javicercasi/Trabajo_Final_3/58004-Cercasi/Documentacion presentada/Tesis/Trabajo Final PPT.pdf

z

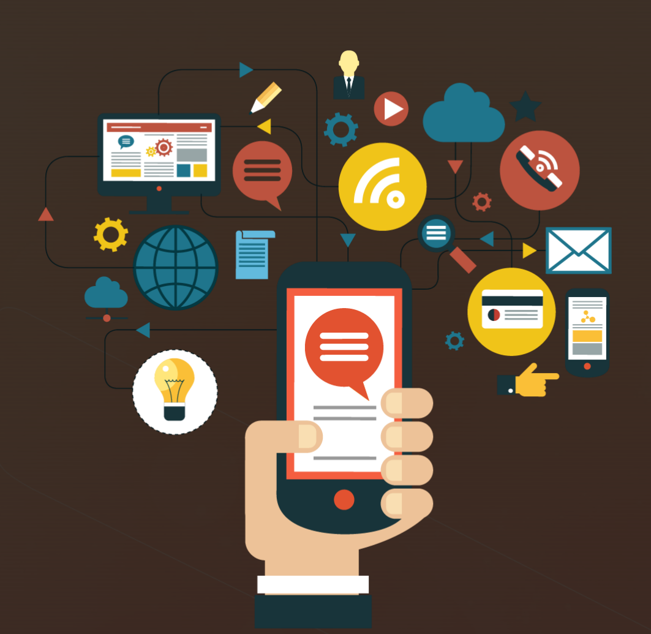
[picture p45: figure]

# Nova: Teléfono Móvil

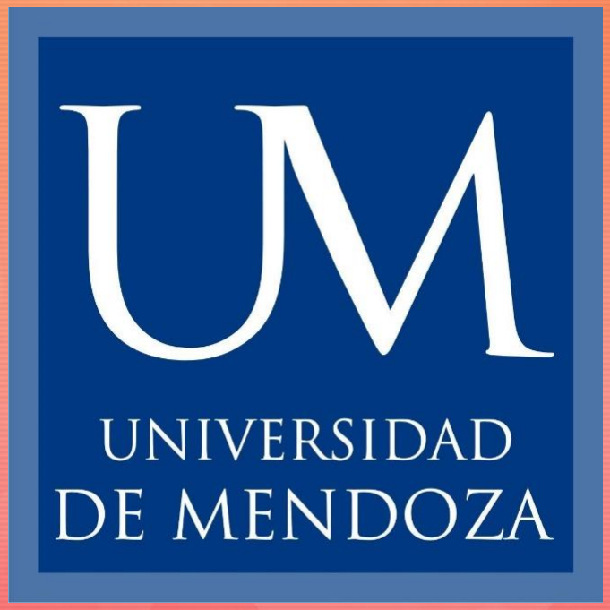
[picture p46: figure]

Trabajo Final
Ingeniería en Computación

Cercasi Javier Agustín

z

## Tabla de contenidos

01

Problema

02

Solución

03

Metodología

05

Demo

06

Conclusiones

04

Arquitectura

07

Mejoras

z

01

# Problema

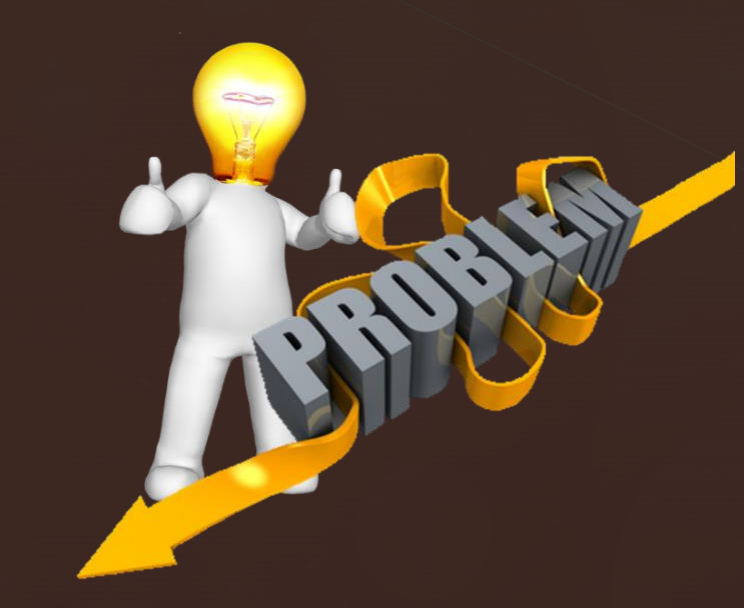
[picture p47: figure]

z

## Problema

- En la actualidad, muchos habitantes de escasos recursos y personas de la tercera edad encuentran dificultades a la hora de hallar y utilizar un dispositivo móvil que sea cómodo y sencillo de manipular. Una buena forma de disminuir esta brecha digital es facilitando su uso, y haciéndolo agradable para estos usuarios.

01

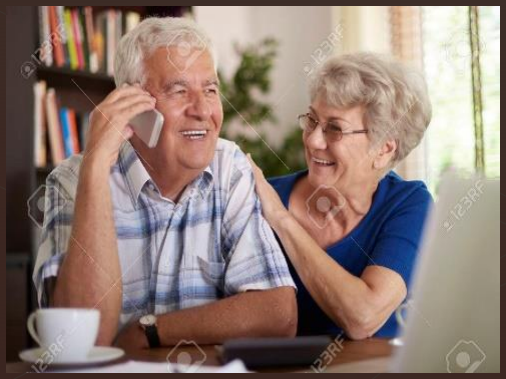
[picture p48: figure]

z

## Justificación del Problema

- Acercar la tecnología a la tercera edad es imprescindible para que puedan estar siempre conectados e integrados en la sociedad por medio de ella. Esta integración resulta además de suma importancia para las familias de estos usuarios, por la tranquilidad que brinda el saber que siempre estarán conectados.

01

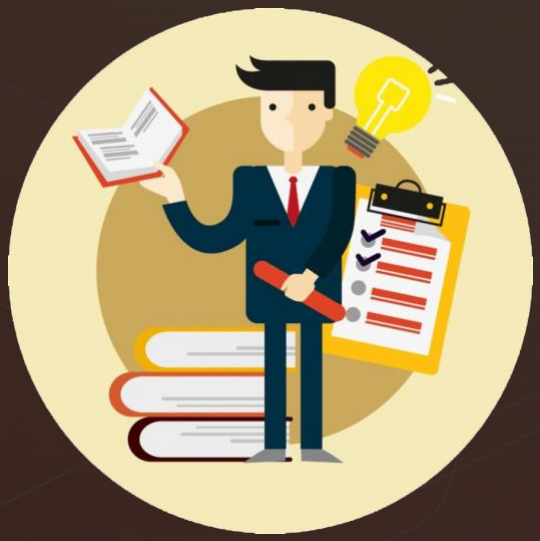
[picture p49: figure]

z

02

# Solución

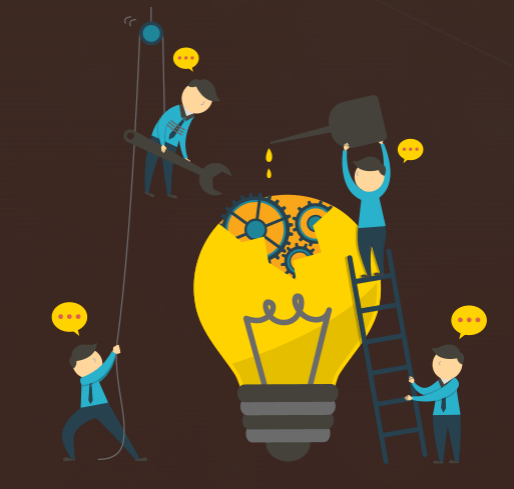
[picture p50: figure]

z

## Solución

- Desarrollar un dispositivo móvil, de una arquitectura sofisticada pero de fácil manejo para el usuario, diseñado especialmente para la tercera edad.

02

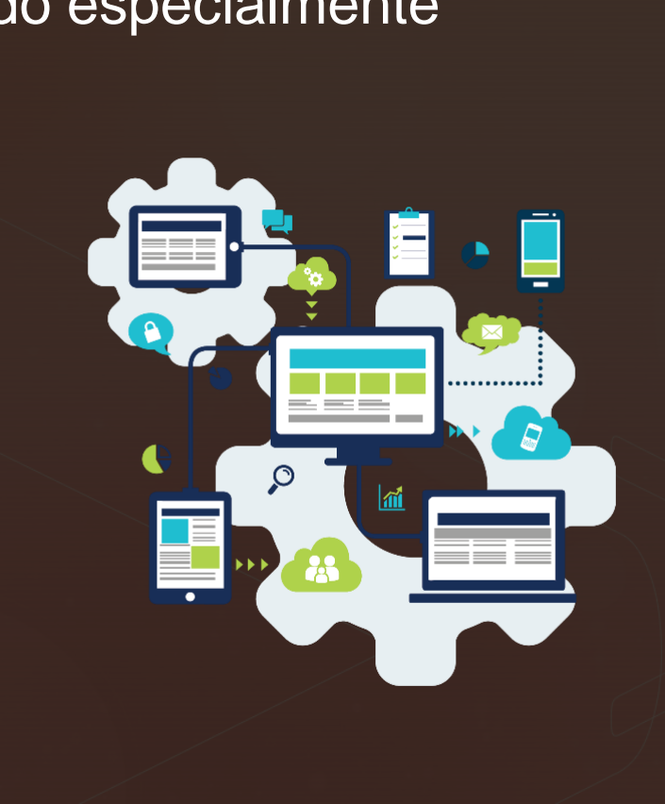
[picture p51: figure]

z

## Funcionalidades

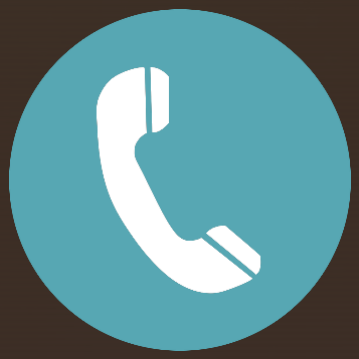
[picture p52: figure]

- Realizar y recibir llamadas.
- Enviar mensajes de texto.
- Interacción con el usuario a través de una experiencia intuitiva.
- Registro de contactos telefónicos (hasta 250 contactos).
- Acceso a la agenda telefónica para seleccionar contactos de destino.
- Conexión a la red para transmitir datos a la nube.
- Acceso a una plataforma web para un seguimiento diario del registro de llamadas.

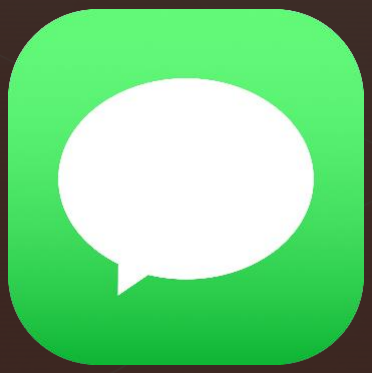
[picture p53: figure]

- Uso de aplicación móvil para el seguimiento del usuario.

02

z

03

# Metodología

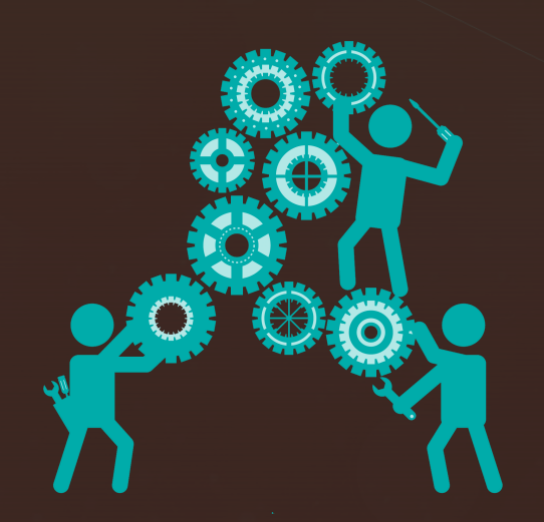
[picture p54: figure]

## Desarrollo y fabricación de Hardware

03

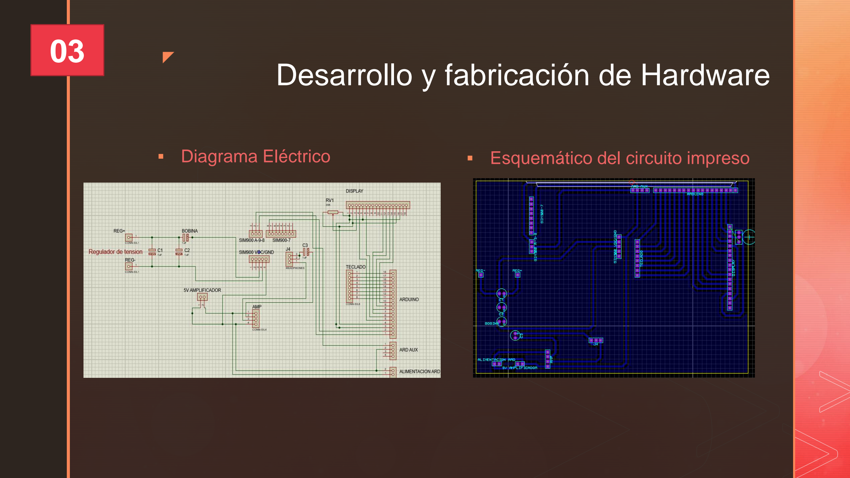
[picture p55: page 10]

z

- | Diagrama Eléctrico | ▪ | Esquemático del circuito impreso

## Desarrollo y fabricación de Hardware

03

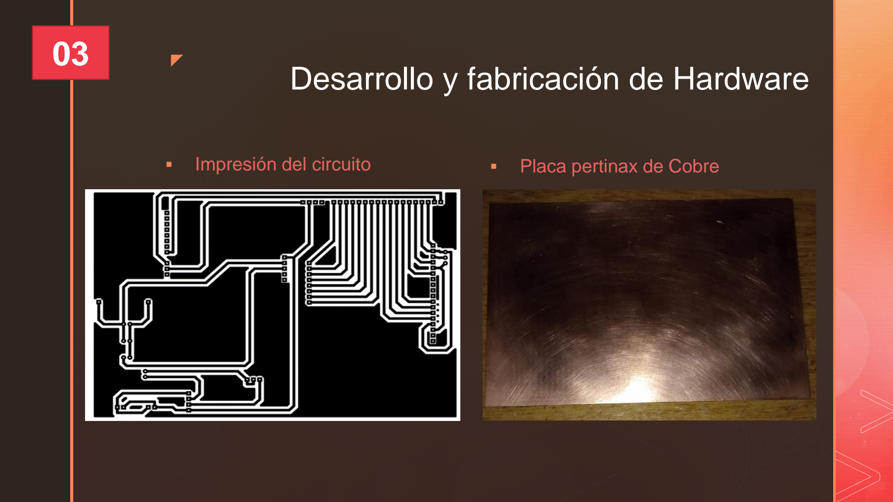
[picture p56: page 11]

z

- | Impresión del circuito | ▪ | Placa pertinax de Cobre

## Desarrollo y fabricación de Hardware

03

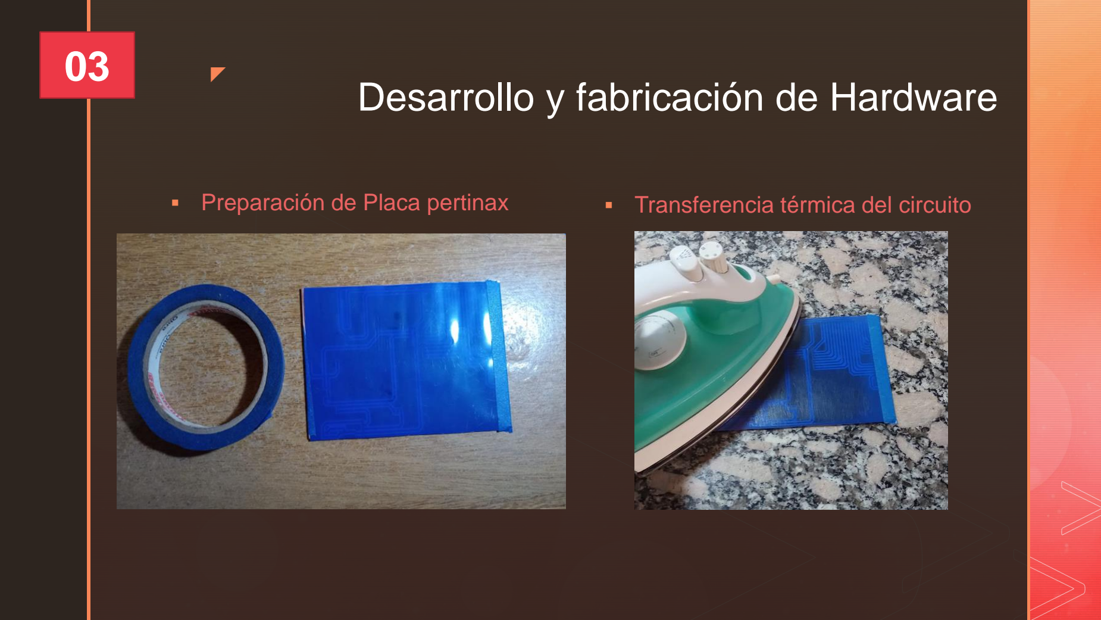
[picture p57: page 12]

z

- | Preparación de Placa pertinax | ▪ | Transferencia térmica del circuito

## Desarrollo y fabricación de Hardware

03

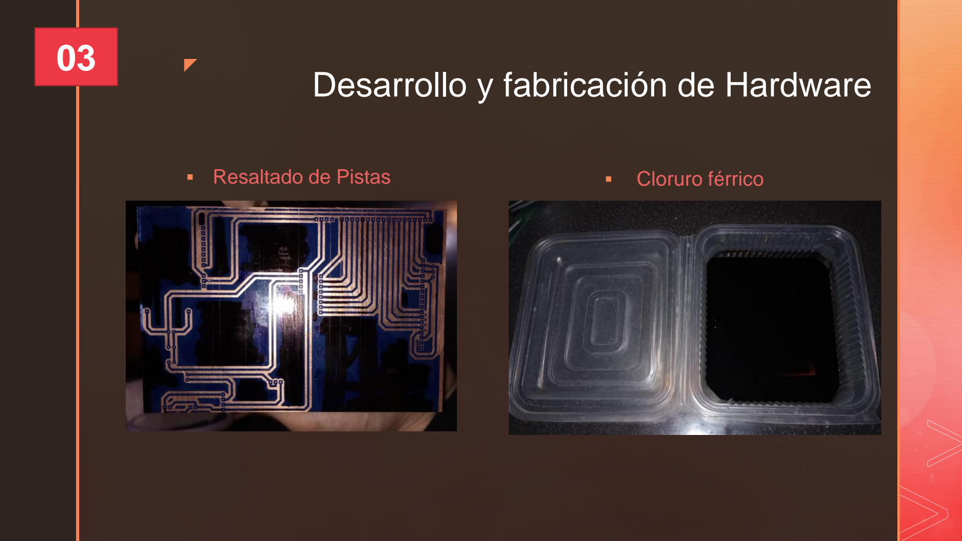
[picture p58: page 13]

z

- | Resaltado de Pistas | ▪ | Cloruro férrico

## Desarrollo y fabricación de Hardware

03

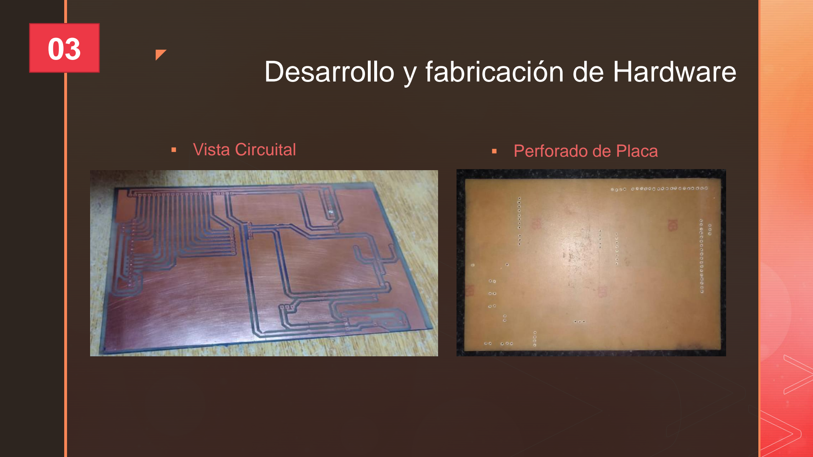
[picture p59: page 14]

z

- | Vista Circuital | ▪ | Perforado de Placa

## Desarrollo y fabricación de Hardware

03

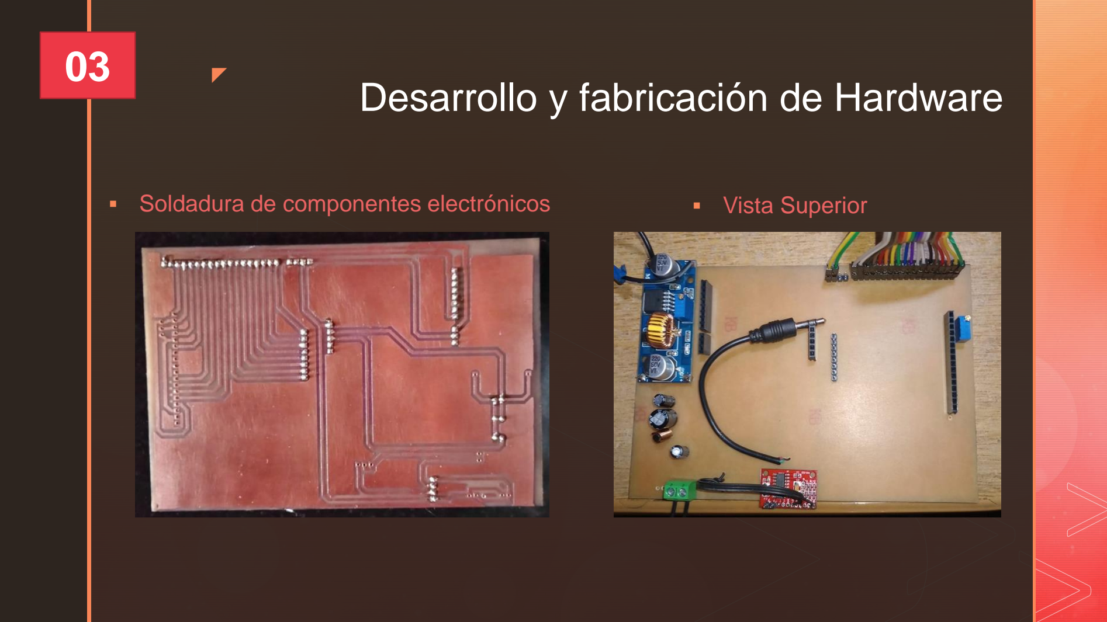
[picture p60: page 15]

z

- | Soldadura de componentes electrónicos | ▪ | Vista Superior

## Desarrollo y fabricación de Hardware

03

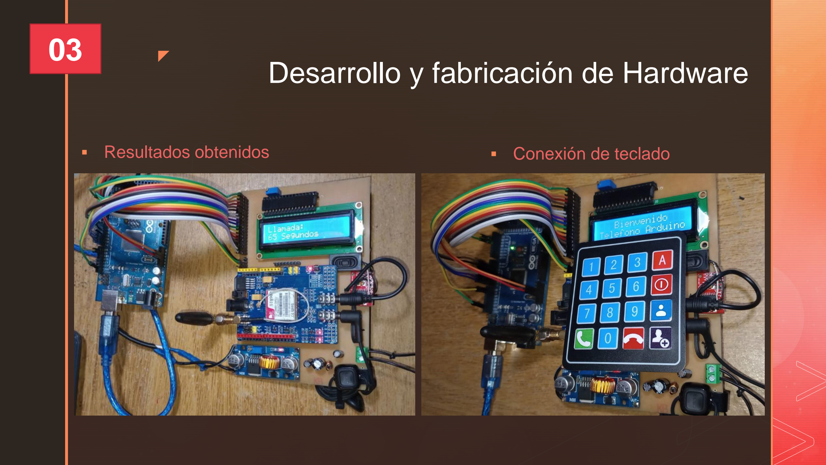
[picture p61: page 16]

z

- | Resultados obtenidos | ▪ | Conexión de teclado

## Desarrollo y fabricación de Hardware

03

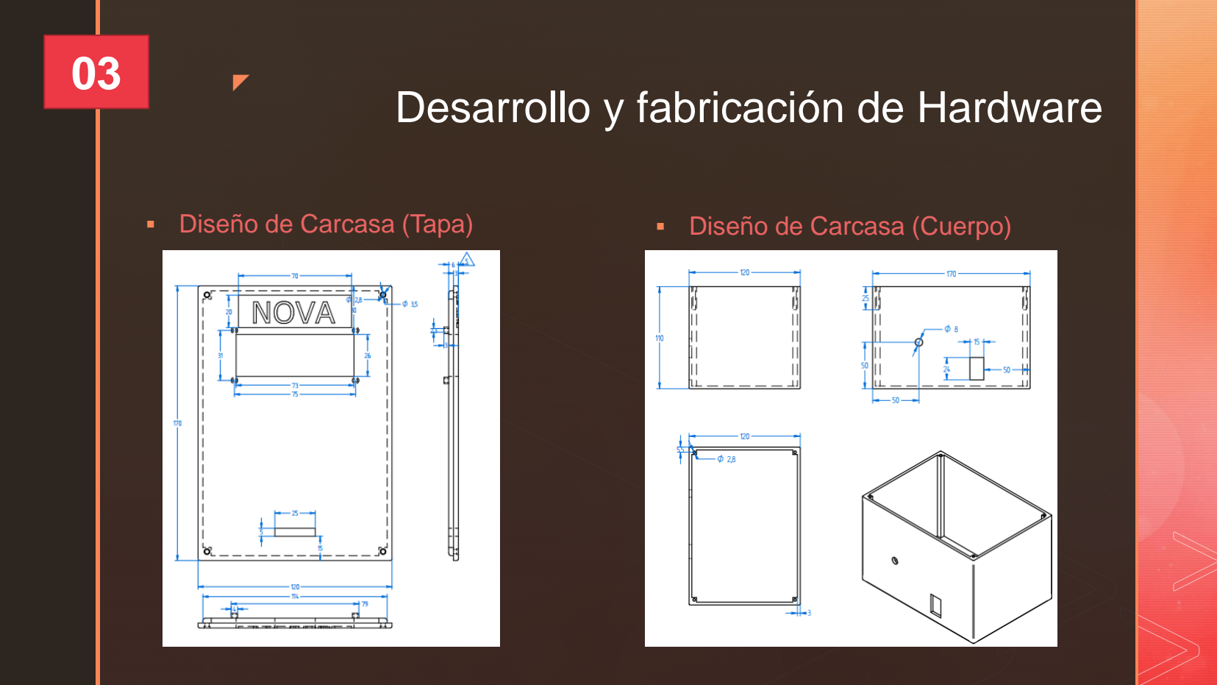
[picture p62: page 17]

z

- | Diseño de Carcasa (Tapa) | ▪ | Diseño de Carcasa (Cuerpo)

## Desarrollo y fabricación de Hardware

03

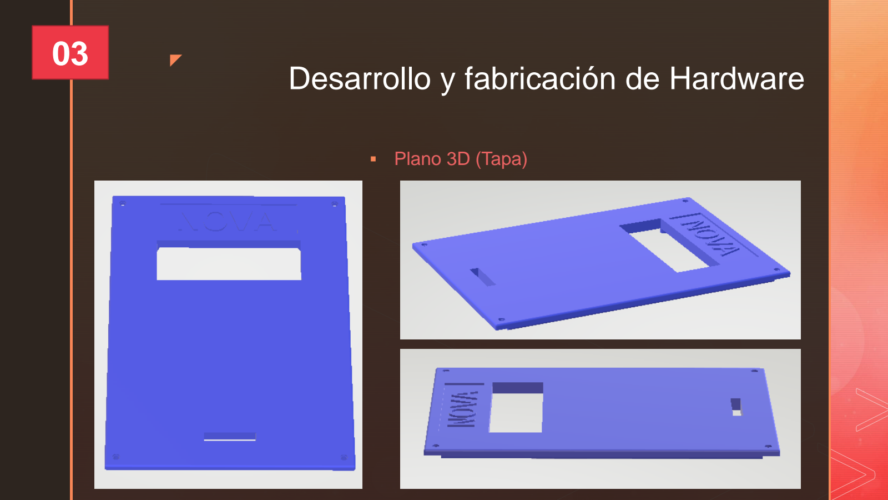
[picture p63: page 18]

z

- Plano 3D (Tapa)

## Desarrollo y fabricación de Hardware

03

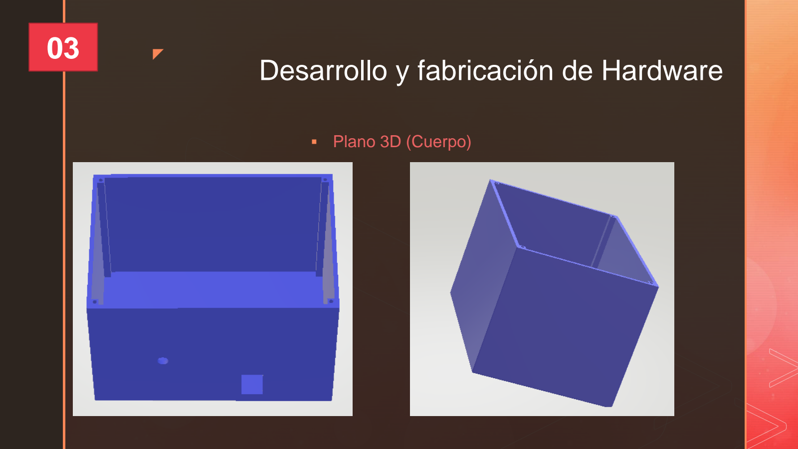
[picture p64: page 19]

z

- Plano 3D (Cuerpo)

## Desarrollo y fabricación de Hardware

03

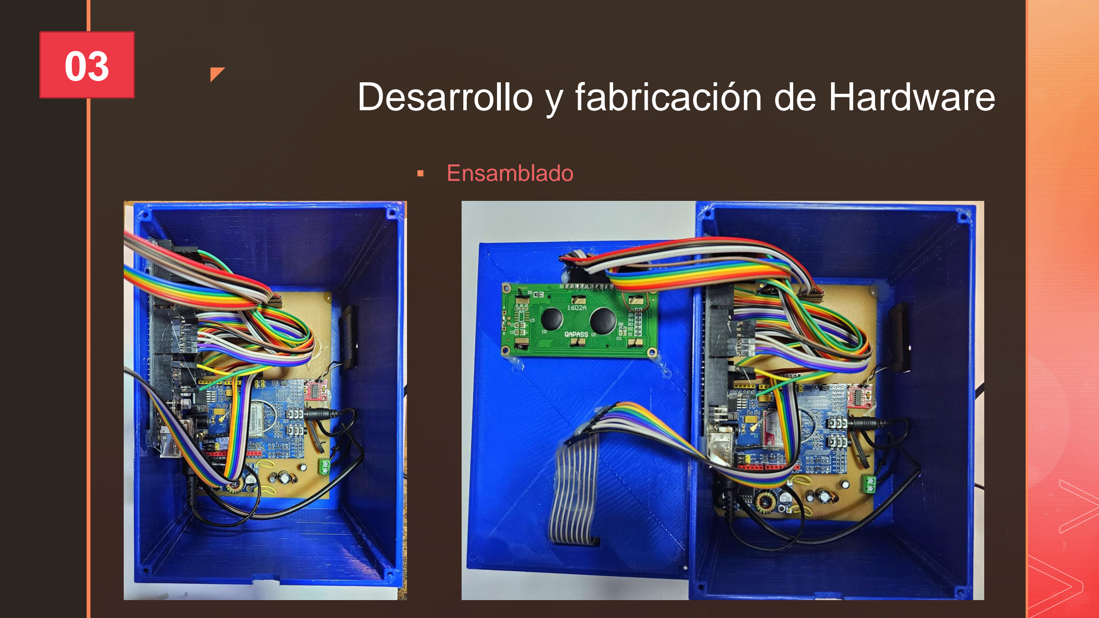
[picture p65: page 20]

z

- Ensamblado

## Desarrollo y fabricación de Hardware

03

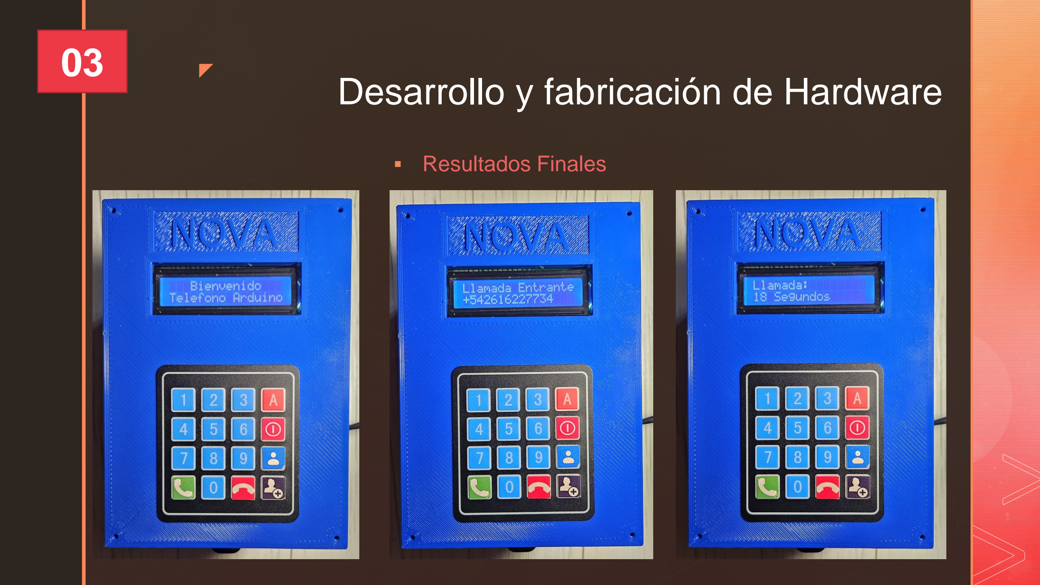
[picture p66: page 21]

z

- Resultados Finales

## Desarrollo y fabricación de Hardware

03

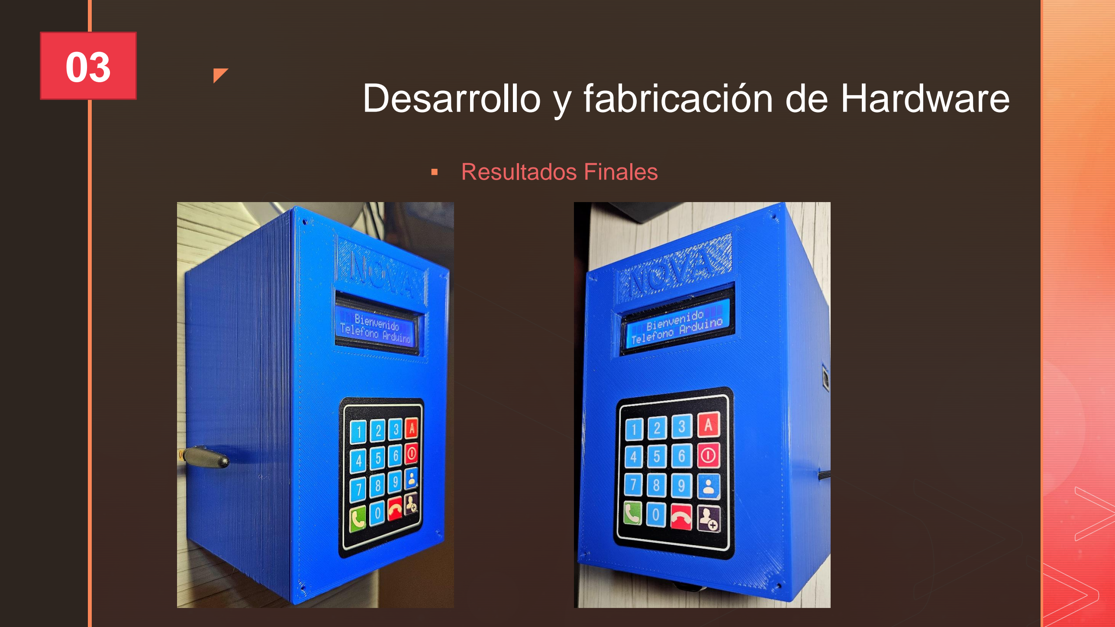
[picture p67: page 22]

z

- Resultados Finales

## Desarrollo de Software

03

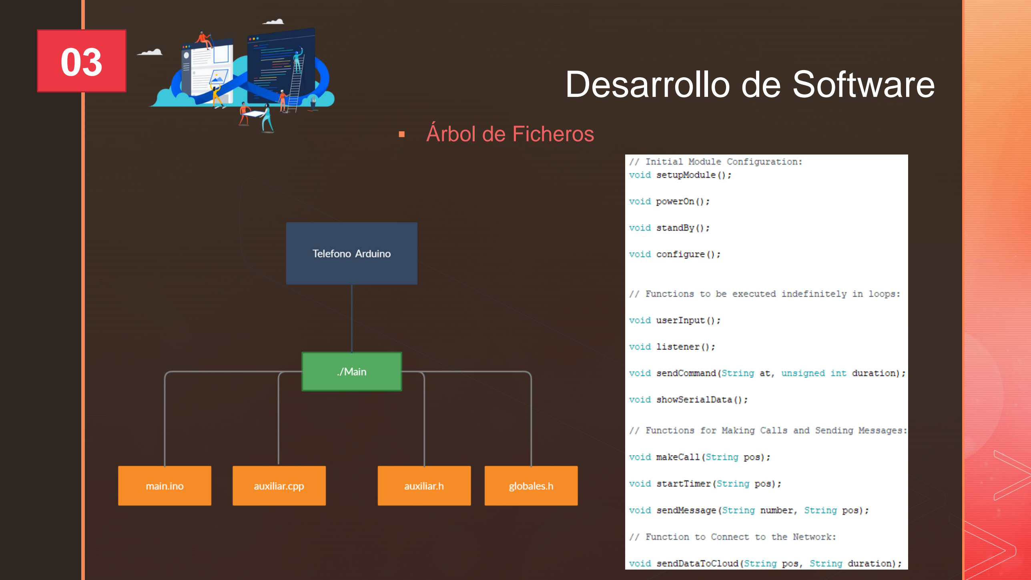
[picture p68: page 23]

z

- Árbol de Ficheros

## Datos registrados en la nube

03

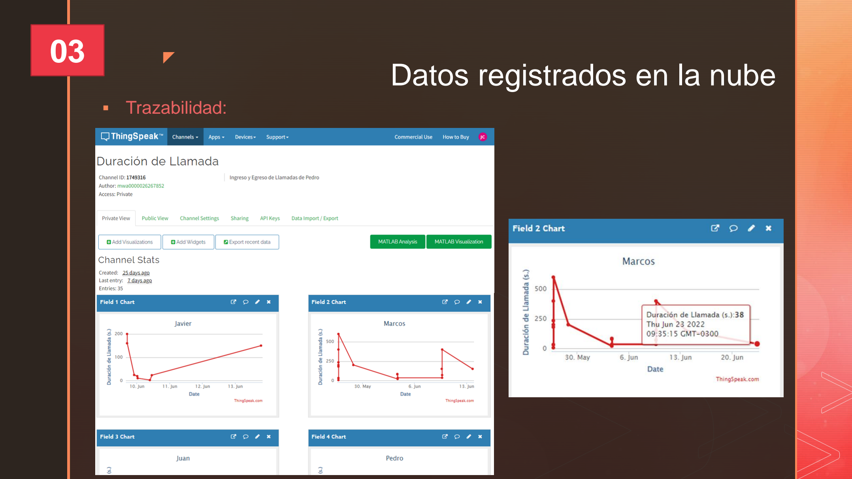
[picture p69: page 24]

z

- Trazabilidad:

## Datos registrados en la nube

03

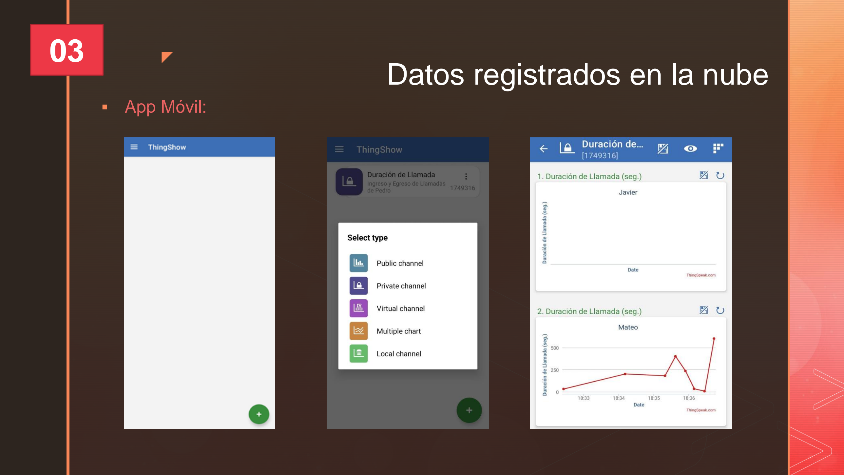
[picture p70: page 25]

z

- App Móvil:

z

04

# Arquitectura

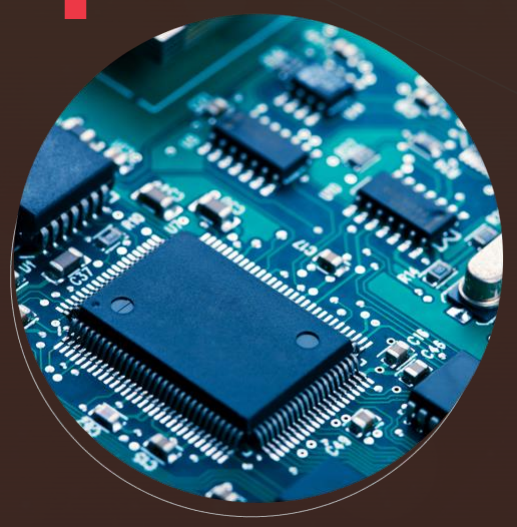
[picture p71: figure]

z

## Arquitectura

04

- Plataforma:

Arduino IDE (Entorno de Desarrollo Integrado)
- Lenguaje:

C++

- Protocolos Físicos:

Serial (PC – Arduino)

Serial Uart (Arduino - Módulo de comunicaciones)

Gsm (Módulo de Comunicaciones)
- Protocolo de Comunicación:

Http (Control)
- Componentes:
- Arduino Mega 2560
- Sim 900L
- Parlante 1w/ 8 Ohms
- Micrófono Electret
- Fuente switch 220V / 12V - Fuente switch 220V / 5V
- Fuente step down dc-dc XL4015
- Amplificador de Audio Pam8403 5-12v
- Teclado Membrana matricial 4x4
- Display LCD 2x16
- Tarjeta sim card
- Placa de Cobre – Cables – Pines – Capacitores - Bobinas

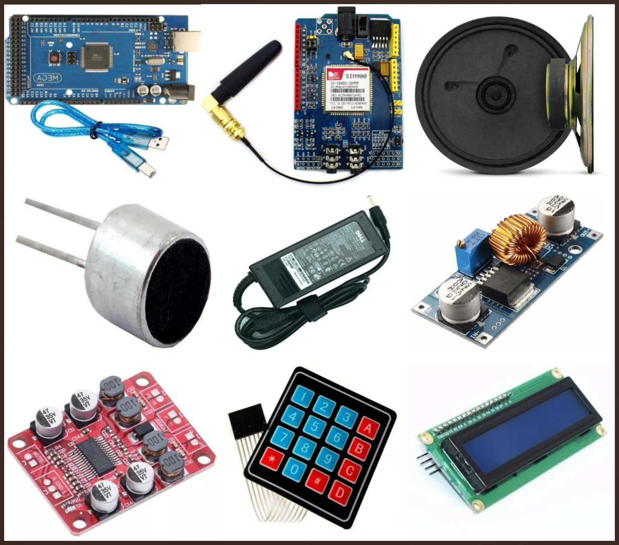
[picture p72: figure]

z | Diagrama Eléctrico 04

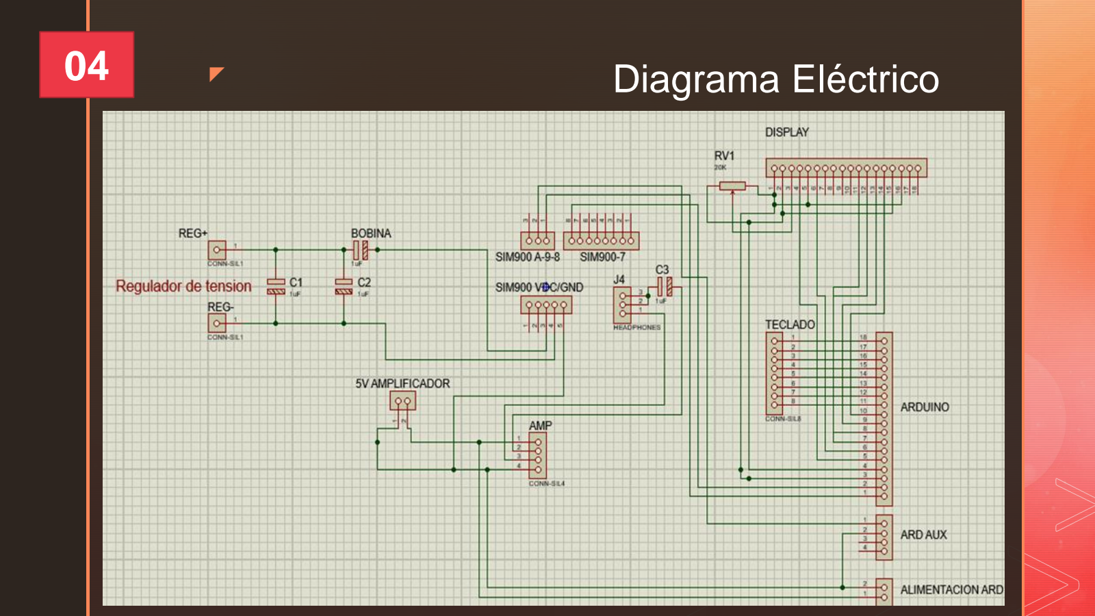
[picture p73: page 28]

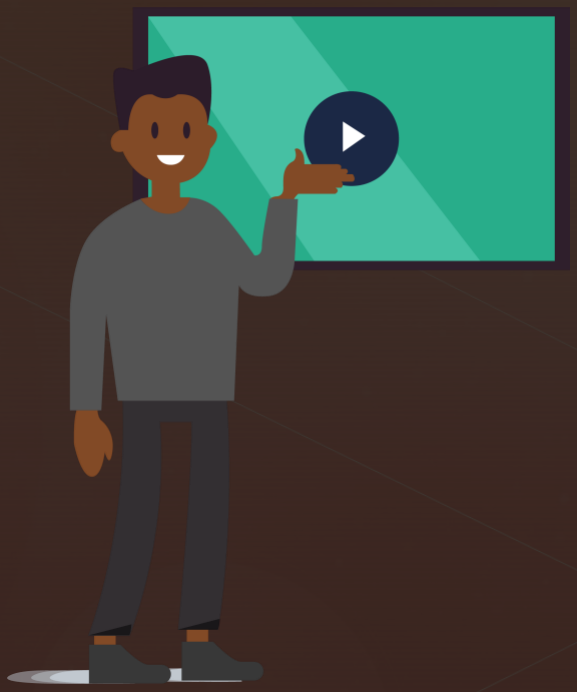
[picture p74: figure]

z

05

# Demo

z | Conclusiones
- Se aseguró la consonancia con los objetivos planteados en el marco referencial, obteniendo el 100% de los objetivos establecidos en la fabricación del dispositivo móvil.
- Se alcanzó el objetivo general: Diseñar un Dispositivo móvil basado en Arduino de fácil manejo para el usuario, desarrollado especialmente para la tercera edad.

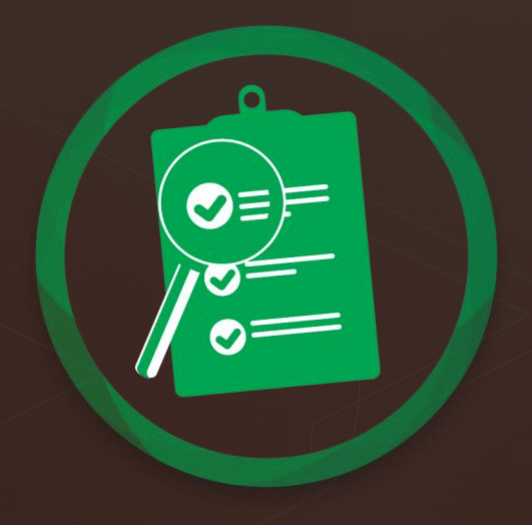
[picture p75: figure]

- Se alcanzaron los objetivos específicos

06

z

06

# Conclusiones

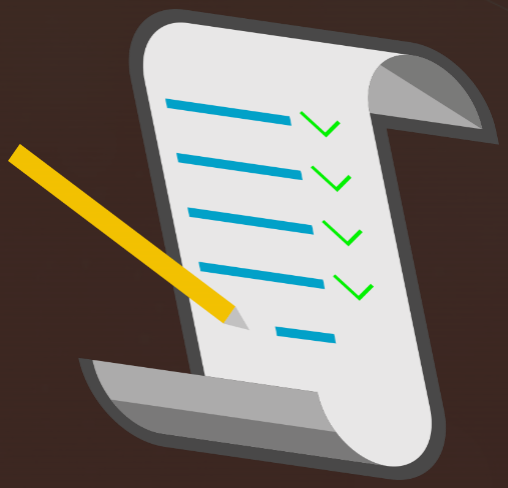
[picture p76: figure]

z | Conclusiones
- Se aseguró la consonancia con los objetivos planteados en el marco referencial, obteniendo el 100% de los objetivos establecidos en la fabricación del dispositivo móvil.
- Se alcanzó el objetivo general: Diseñar un Dispositivo móvil basado en Arduino de fácil manejo para el usuario, desarrollado especialmente para la tercera edad.
- Se alcanzaron los objetivos específicos

06

z

07

# Mejoras

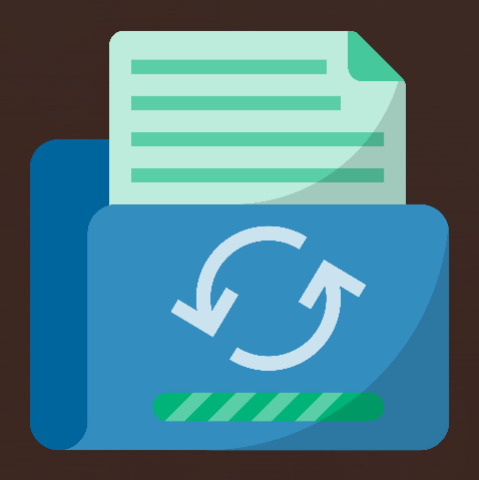
[picture p77: figure]

z

## Líneas Futuras

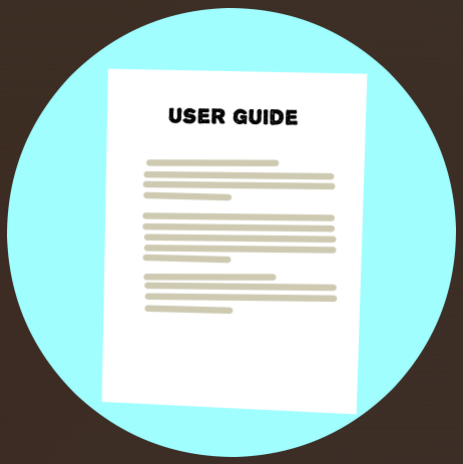
[picture p78: figure]

- Desarrollo de manual de usuario.
- Agregado de rastreo móvil.

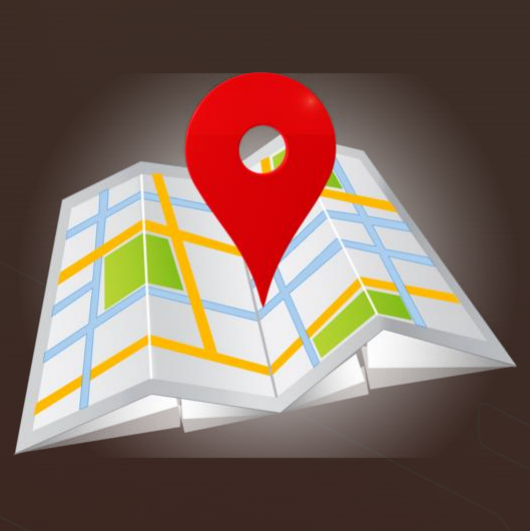
[picture p79: figure]

- Pantalla de mayor tamaño.
- Transición a Alimentación por Batería

07

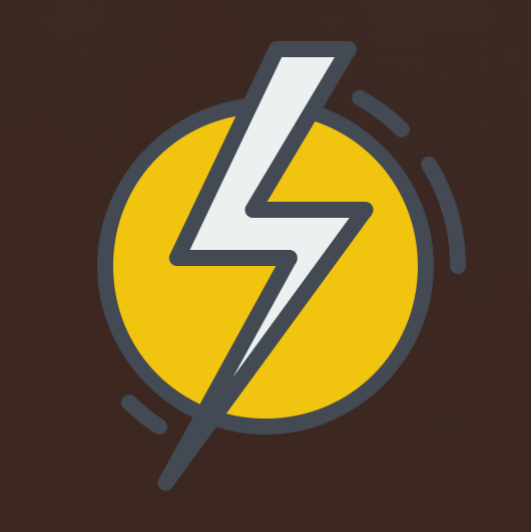
[picture p80: figure]

z

08

# ¿Preguntas?

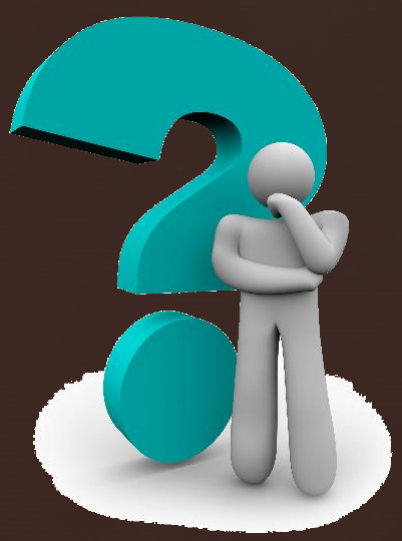
[picture p81: figure]
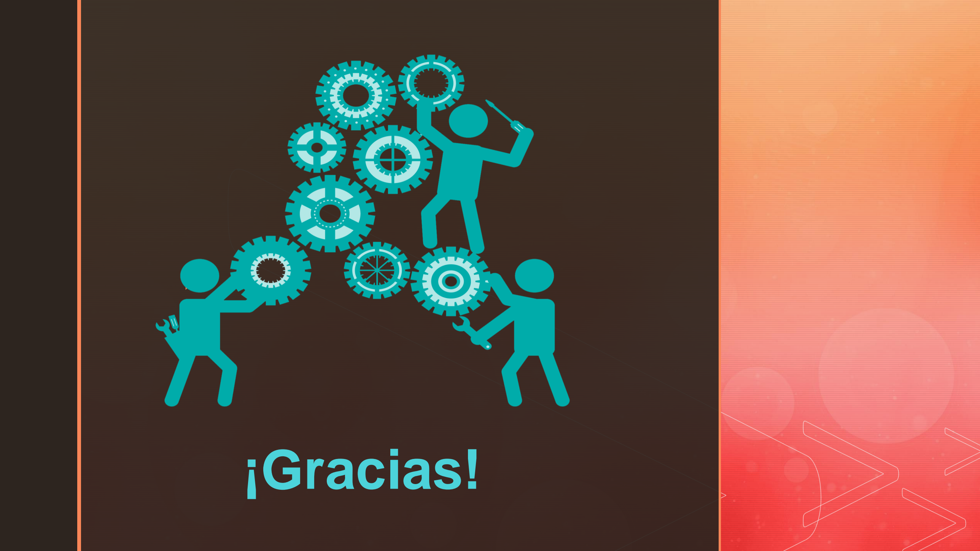
[picture p82: page 36]

z

# ¡Gracias!
