javicercasi/Trabajo_Final_3/58004-Cercasi/Circuito Esquematico.png

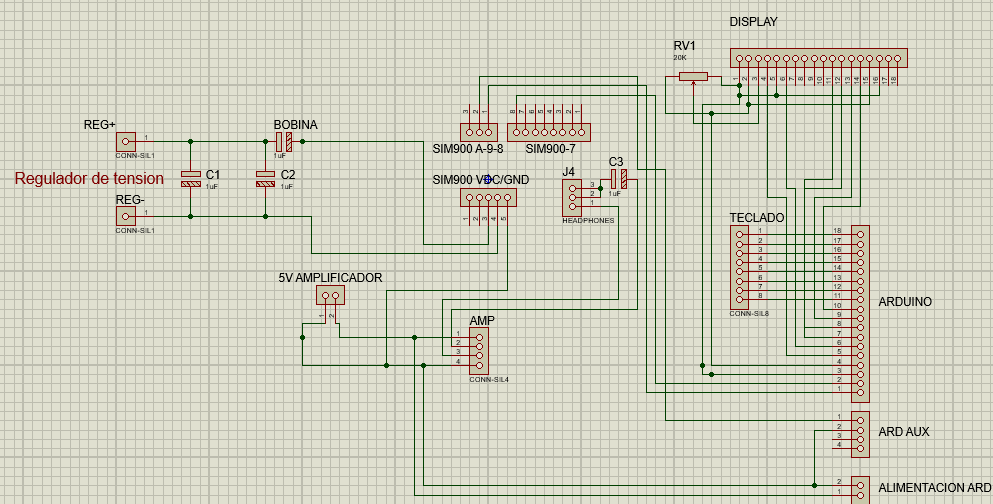
58004-Cercasi/Circuito Esquematico.png
