javicercasi/Trabajo_Final_3/58004-Cercasi/PCB Layout.png

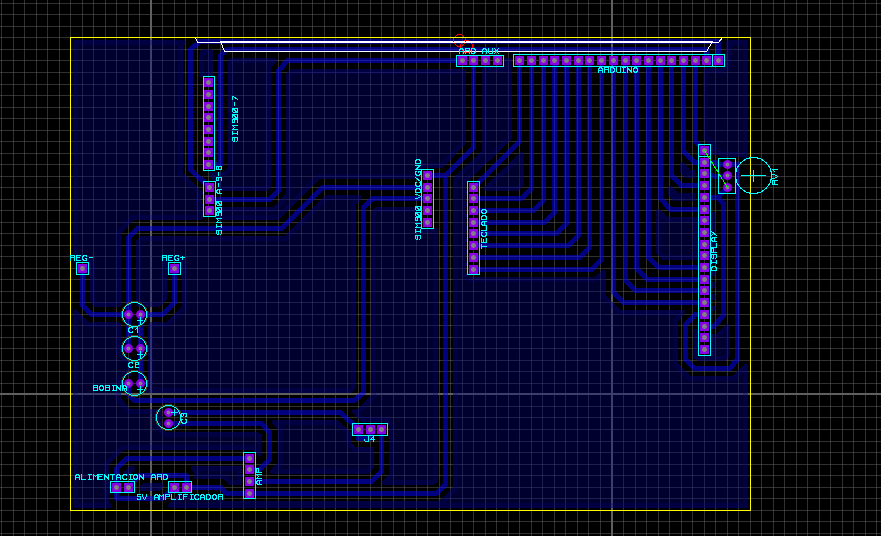
58004-Cercasi/PCB Layout.png
