javicercasi/Trabajo_Final_3/58004-Cercasi/Simulador 3D 1.png

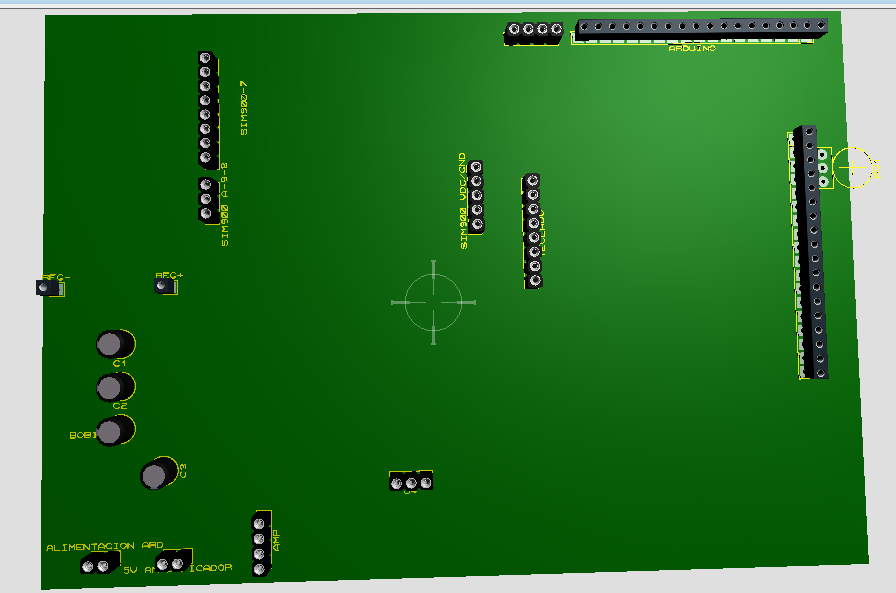
58004-Cercasi/Simulador 3D 1.png
