javicercasi/Trabajo_Final_3/58004-Cercasi/Simulador 3D.png

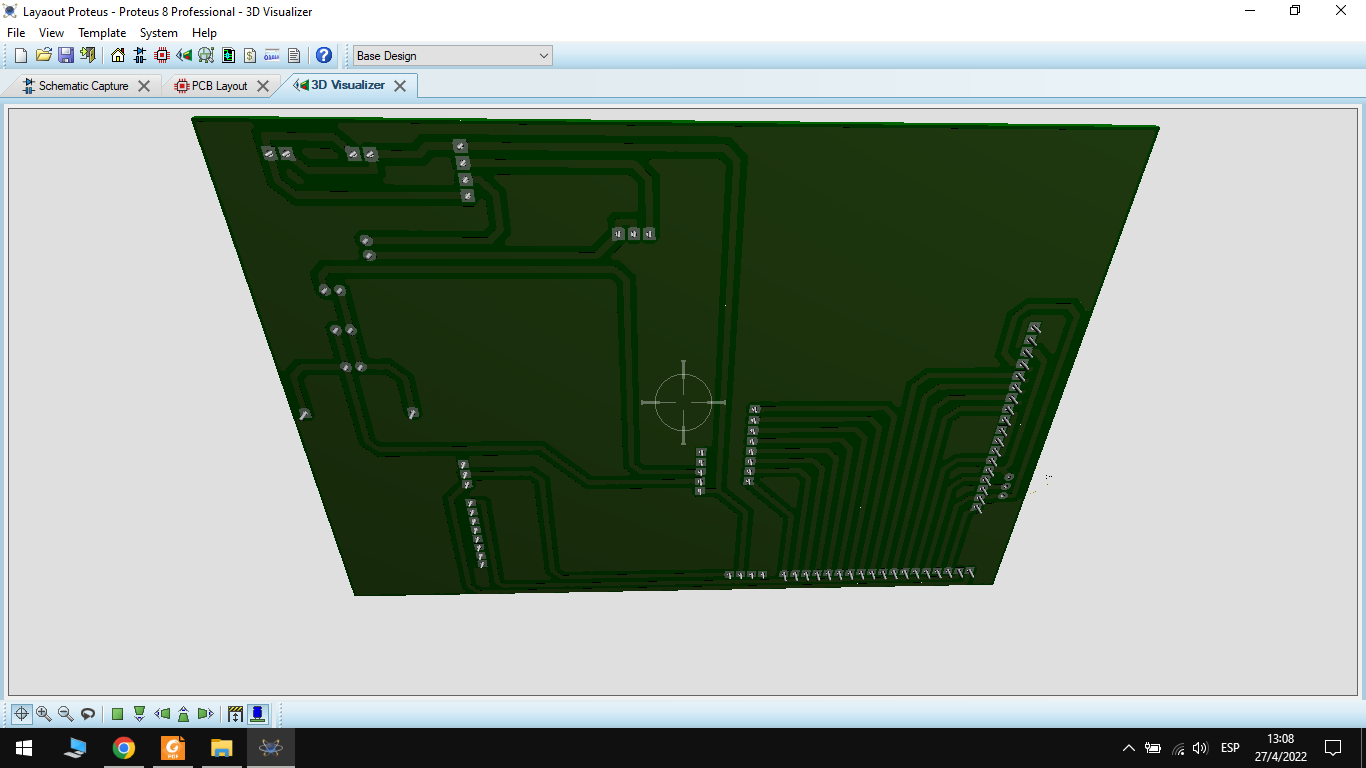
58004-Cercasi/Simulador 3D.png
