javicercasi/Trabajo_Final_3/58004-Cercasi/Imagenes Fabricacion Placa/8.jpeg

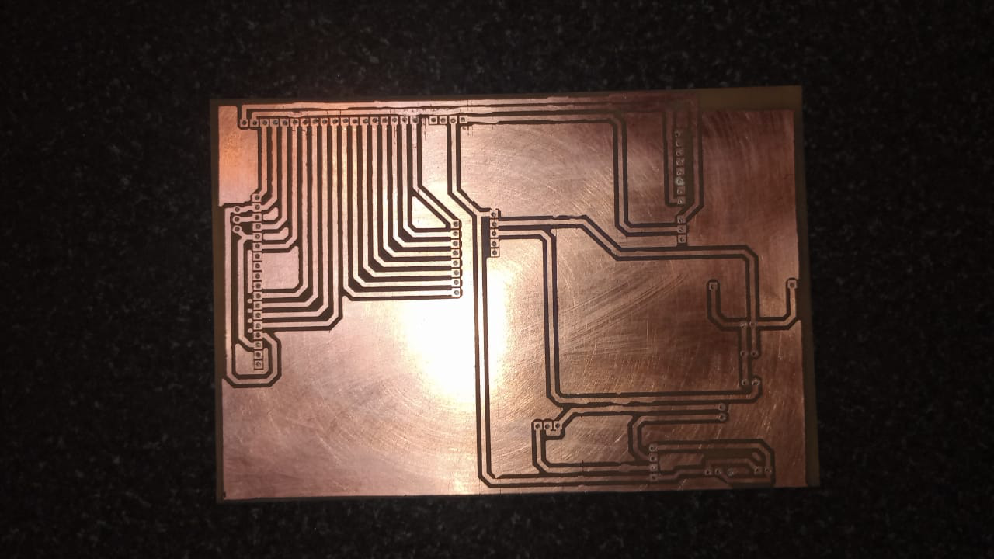
58004-Cercasi/Imagenes Fabricacion Placa/8.jpeg
