javicercasi/Trabajo_Final_3/58004-Cercasi/Imagenes Fabricacion Placa/22.png

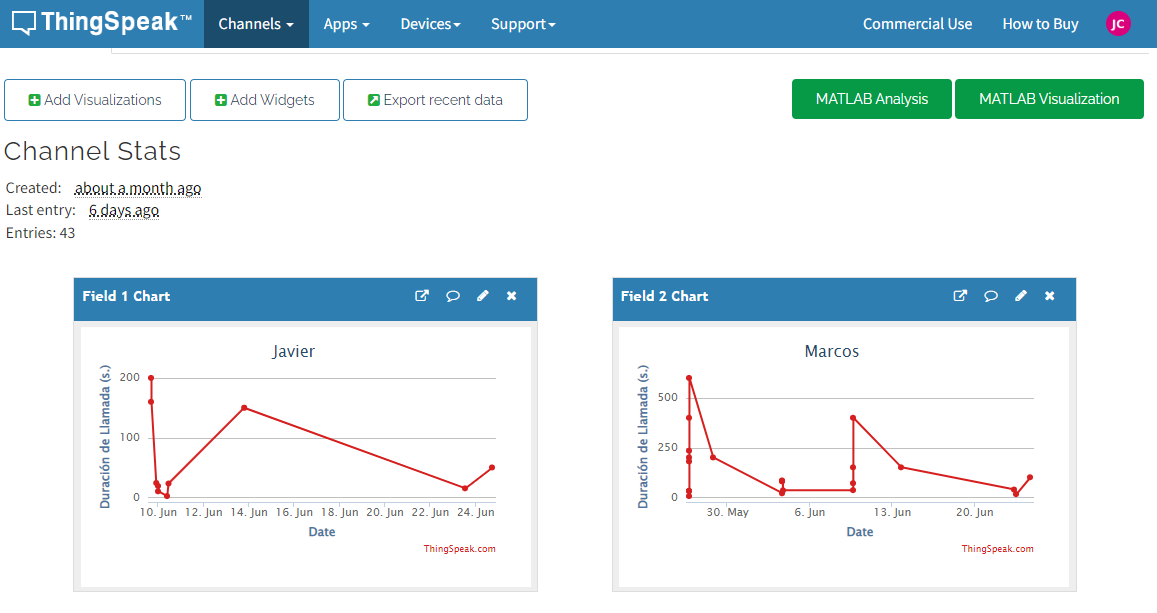
58004-Cercasi/Imagenes Fabricacion Placa/22.png
