javicercasi/Trabajo_Final_3/58004-Cercasi/Circuito impreso Espejo.pdf

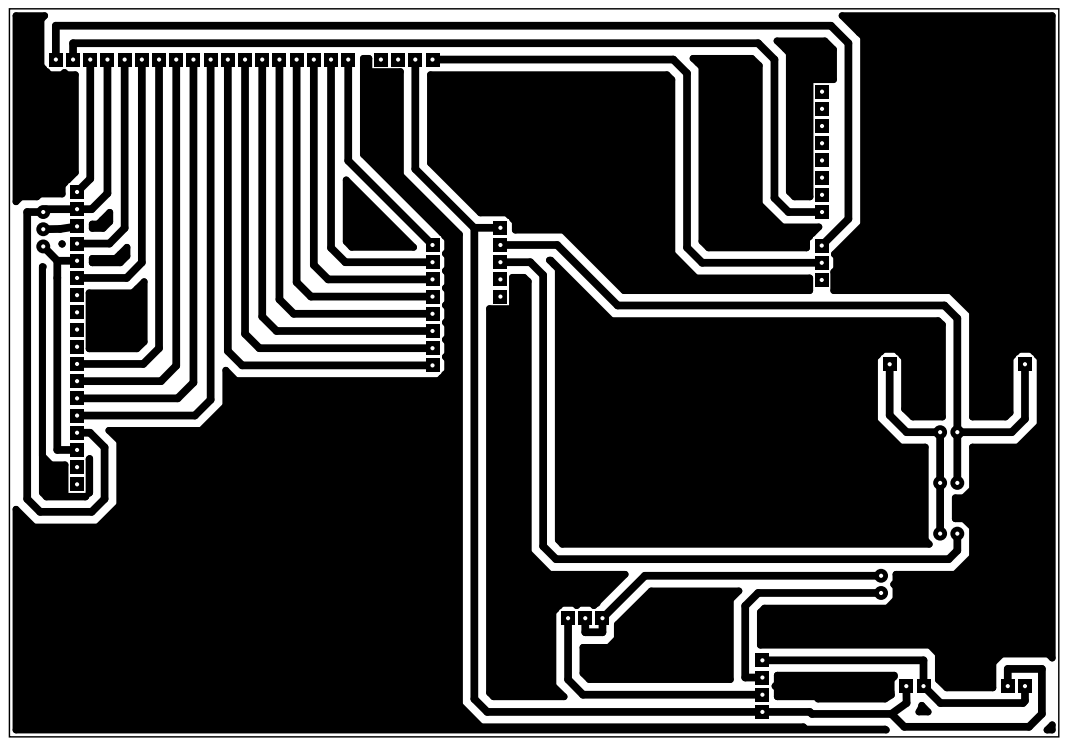
[picture p103: page 1]
