javicercasi/Trabajo_Final_3/58004-Cercasi/Circuito impreso.pdf

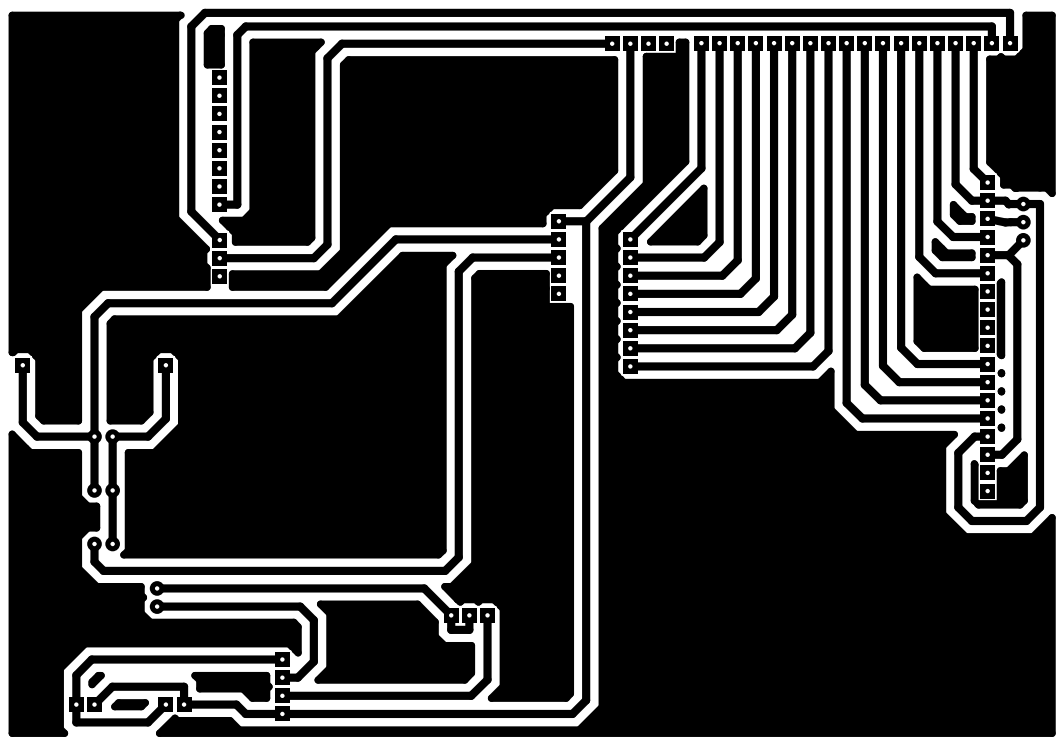
[picture p104: page 1]
