javicercasi/Trabajo_Final_3/(list of files, drawings)

Other design files:
58004-Cercasi/Layaout Proteus.pdsprj
