javicercasi/Trabajo_Final_3/(commit log)

2022-04-16 commit local
    [layaout antes de generar 2.pdsprj, layaout antes de generar 3.pdsprj, layaout antes de generar 4.pdsprj, layaout antes de generar.pdsprj]
2022-04-27 comit local
    [Layaout Proteus.pdsprj, layaout antes de generar 2.pdsprj, layaout antes de generar 3.pdsprj, layaout antes de generar 4.pdsprj, layaout antes de generar.pdsprj]
2022-05-16 Mejoras de Placa (Cambio de Amplificador)
